okapmna/incubatorESP32WiFiAP/(commit log)

2026-01-26 Reorganize README and enhance MQTT version details
    Rearranged the order of the versions in the README and added detailed descriptions for the MQTT version, including features, hardware components, pin configuration, usage instructions, and schematic.
2026-01-26 add schematic image
2026-01-26 move skematik to schematics directory
2026-01-26 Update schematic images and section titles in README
2026-01-27 Update schematic section with additional image
2026-02-09 optimize PID & replace dht22 with aht20
    [incubator_esp32_mqtt.ino]
2026-04-01 add humidifier protection tolerance
    [incubator_esp32_mqtt.ino]
2026-05-17 add 0.96 lcd & aht20 sensor
2026-05-17 fix lcd 16x2 cannot display
    [incubator_esp32_mqtt.ino]
2026-05-18 add oled menu with rotary sensor for selector
2026-08-05 restructure to Arduino IDE sketch layout
2026-08-05 replace AHT20 sensor with SHT30
2026-10-02 switch TFT to portrait 128x160 with non-blocking SHT30 retry and failsafe
    - Layout portrait: stacked suhu/lembaban sections, rotation 0
    - Sensor init non-blocking, retry begin every 5s without halting boot
    - Failsafe heater OFF when sensor invalid, fan/servo/menu keep running
    - Show --.- when NAN, skip MQTT publish of invalid readings
    - Add display dirty flag with 50ms cooldown, MQTT reconnect 10s
    [incubator_esp32_mqtt.ino]
2026-10-02 penyesuaian sensifitas rotary sensor dan fix screen flickering
    [incubator_esp32_mqtt.ino]
2026-10-07 update : ganti teks status WiFi dengan ikon bitmap di topbar
2026-10-09 docs: perbarui README pin, komponen, dan dokumentasi firmware terbaru
2026-11-10 led for egg candling & new credential format
2026-11-11 panggil initDeviceId di awal setup dan tampilkan di serial
2026-11-12 feat: fan & servo targets via MQTT with 512-byte command buffer
    - Terima target_fan/fan_speed, servo_mode (0=JADWAL, 1=SWING) dan
    servo_interval (1-24 jam) dari dashboard via topik /con
    - Perintah servo dititipkan lewat volatile servo_cmd_* dan dieksekusi
    di loop Core 1 (updateServo), lalu disimpan ke NVS
    - Naikkan buffer JSON PubSubClient ke 512 byte (setBufferSize) karena
    payload perintah melebihi default 256
    - dev_getinfo & publishSensorData kini menyertakan servo_interval,
    target_temp dan target_hum untuk sinkronisasi dua arah
2026-11-12 feat: candling LED auto-on 30s when dashboard triggers photo capture
    - Perintah teks "capture" maupun JSON {"action":"capture"} menyalakan
    LED candling CANDLE_CAPTURE_SEC (30 detik) sebagai sorot telur
    - Fallback pencarian substring action/capture untuk payload mentah
    yang gagal parse, plus dokumentasi perintah diperbarui
2026-11-14 led capture duration
